donpivo/uv_lightbox/Schematic/PSU/PSU.kicad_pcb

## KiCad design Schematic/PSU/PSU.kicad_pcb (2020-11-04)

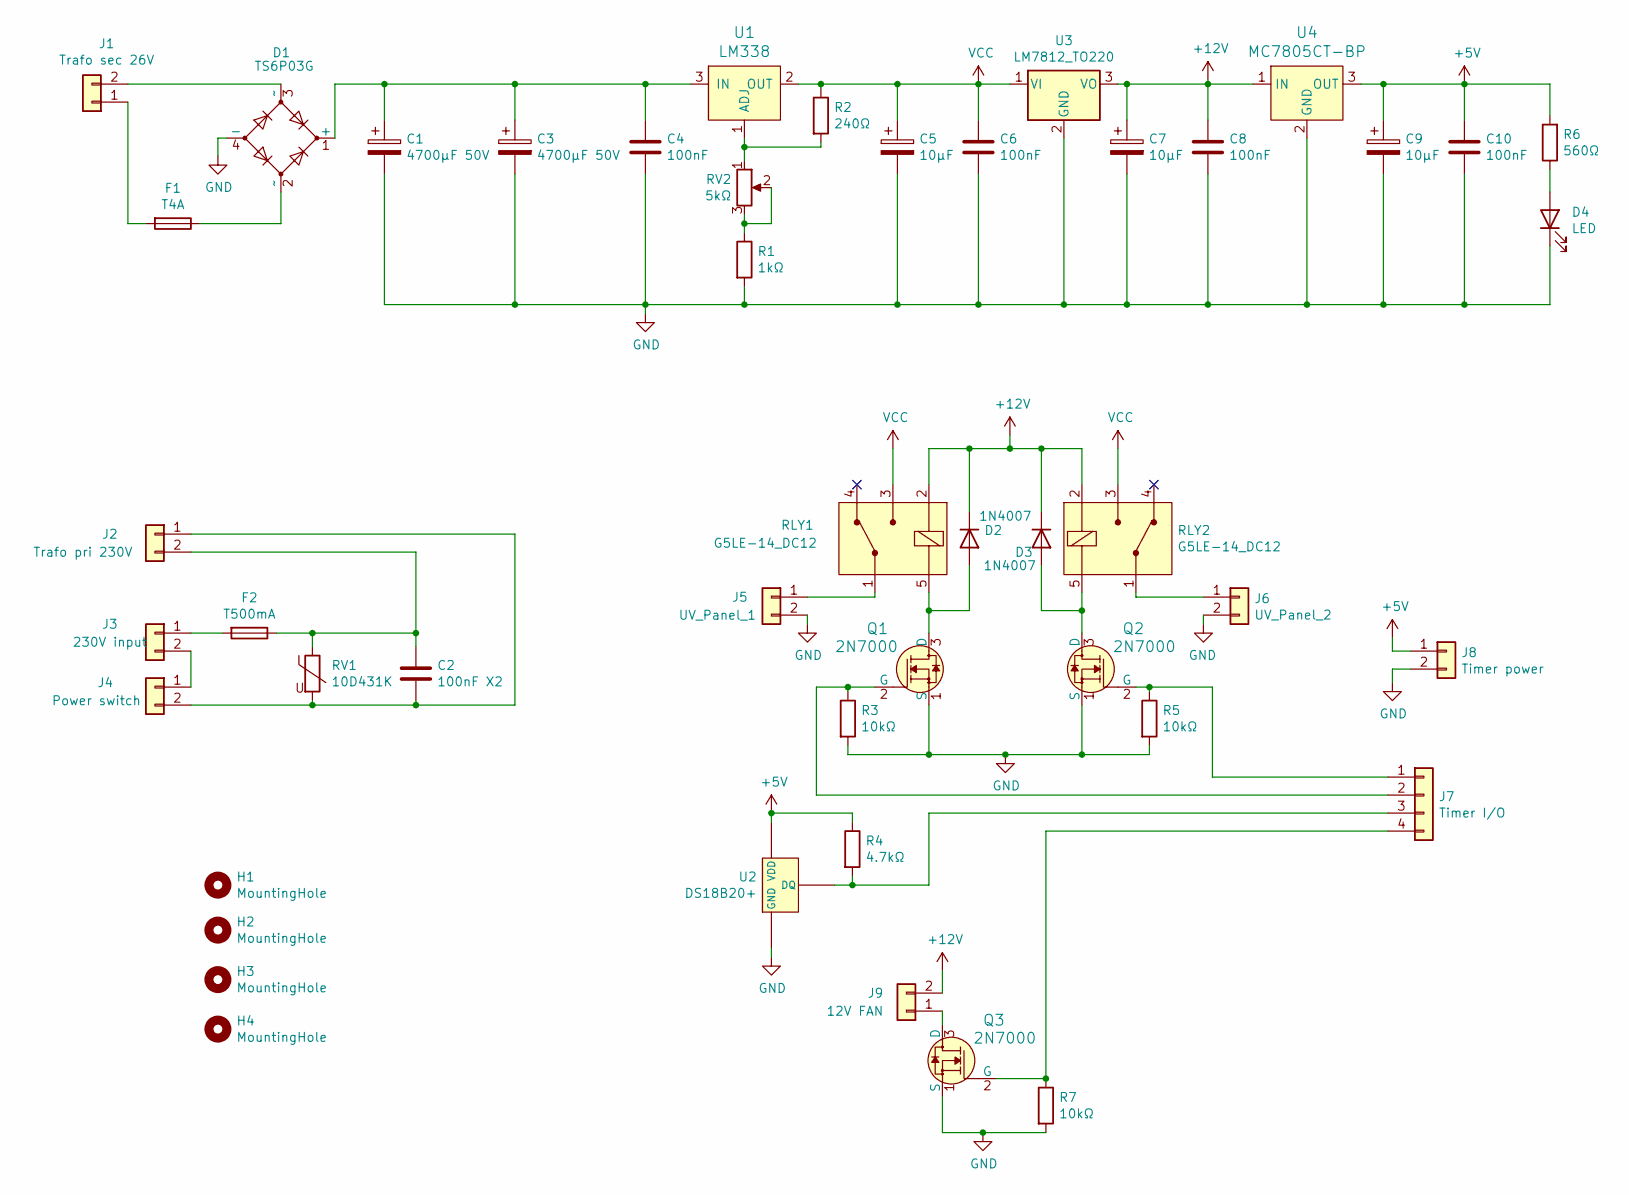
[picture p1: schematic PSU.sch]

Parts:
C1, C3: 4700µF 50V; CP_Radial_D22.0mm_P10.00mm_SnapIn
C2: 100nF X2; C_Rect_L18.0mm_W6.0mm_P15.00mm_FKS3_FKP3
C4, C6, C8, C10: 100nF; C_Rect_L7.2mm_W2.5mm_P5.00mm_FKS2_FKP2_MKS2_MKP2
C5, C7, C9: 10µF; CP_Radial_D5.0mm_P2.00mm
D1: TS6P03G; Generic_rectifier
D2, D3: 1N4007; D_DO-41_SOD81_P10.16mm_Horizontal
D4: LED; LED_D3.0mm
F1: T4A; Fuseholder_Cylinder-5x20mm_Closed
F2: T500mA; Fuseholder_Cylinder-5x20mm_Closed
H1, H2, H3, H4: MountingHole; MountingHole_3.2mm_M3
J1: Trafo sec 26V; TerminalBlock_LCSC_P5.08mm
J2: Trafo pri 230V; TerminalBlock_LCSC_P5.08mm
J3: 230V input; TerminalBlock_LCSC_P5.08mm
J4: Power switch; TerminalBlock_LCSC_P5.08mm
J5: UV_Panel_1; TerminalBlock_LCSC_P5.08mm
J6: UV_Panel_2; TerminalBlock_LCSC_P5.08mm
J7: Timer I/O; KF2510-4P
J8: Timer power; KF2510-2P
J9: 12V FAN; KF2510-2P
Q1, Q2, Q3: 2N7000; TO-92-3; MPN 2N7000; Digi-Key_PN 2N7000FS-ND
R1: 1kΩ; R_Axial_DIN0207_L6.3mm_D2.5mm_P7.62mm_Horizontal
R2: 240Ω; R_Axial_DIN0207_L6.3mm_D2.5mm_P7.62mm_Horizontal
R3, R5, R7: 10kΩ; R_Axial_DIN0207_L6.3mm_D2.5mm_P7.62mm_Horizontal
R4: 4.7kΩ; R_Axial_DIN0207_L6.3mm_D2.5mm_P7.62mm_Horizontal
R6: 560Ω; R_Axial_DIN0207_L6.3mm_D2.5mm_P7.62mm_Horizontal
RLY1, RLY2: G5LE-14_DC12; Relay_THT_G5LE-14; MPN G5LE-14 DC12; Digi-Key_PN Z1012-ND
RV1: 10D431K; RV_Disc_D12mm_W4.5mm_P7.5mm
RV2: 5kΩ; Potentiometer_Bourns_3296W_Vertical
U1: LM338; TO-220-3; MPN LM317T; Digi-Key_PN 497-1575-5-ND
U2: DS18B20+; TO127P482X368X883-3
U3: LM7812_TO220; TO-220-3
U4: MC7805CT-BP; TO-220-3; MPN MC7805CT-BP; Digi-Key_PN MC7805CT-BPMS-ND

Connections:
+5V: C9.1, C10.1, J8.1, R4.1, R6.2, U2.3 (VDD), U4.3 (OUT)
+12V: C7.1, C8.1, D2.1 (K), D3.1 (K), J9.2, RLY1.2 (COIL), RLY2.2 (COIL), U3.3 (VO), U4.1 (IN)
GND: C1.2, C3.2, C4.2, C5.2, C6.2, C7.2, C8.2, C9.2, C10.2, D1.4 (-), D4.1 (K), J5.2, J6.2, J8.2, Q1.1 (S), Q2.1 (S), Q3.1 (S), R1.2, R3.2, R5.2, R7.2, U2.1 (GND), U3.2 (GND), U4.2 (GND)
unnamed: C1.1, C3.1, C4.1, D1.1 (+), U1.3 (IN)
unnamed: C2.1, F2.1, J2.2, RV1.1
unnamed: C2.2, J2.1, J4.2, RV1.2
unnamed: D1.2 (~~), F1.1
unnamed: D1.3 (~~), J1.2
unnamed: D2.2 (A), Q1.3 (D), RLY1.5 (COIL)
unnamed: D3.2 (A), Q2.3 (D), RLY2.5 (COIL)
unnamed: D4.2 (A), R6.1
unnamed: F1.2, J1.1
unnamed: F2.2, J3.1
unnamed: J3.2, J4.1
unnamed: J5.1, RLY1.1 (COM)
unnamed: J6.1, RLY2.1 (COM)
unnamed: J7.1, Q2.2 (G), R5.1
unnamed: J7.2, Q1.2 (G), R3.1
unnamed: J7.3, R4.2, U2.2 (DQ)
unnamed: J7.4, Q3.2 (G), R7.1
unnamed: J9.1, Q3.3 (D)
unnamed: R1.1, RV2.2, RV2.3
unnamed: R2.2, RV2.1, U1.1 (ADJ)
VCC: C5.1, C6.1, R2.1, RLY1.3 (NO), RLY2.3 (NO), U1.2 (OUT), U3.1 (VI)

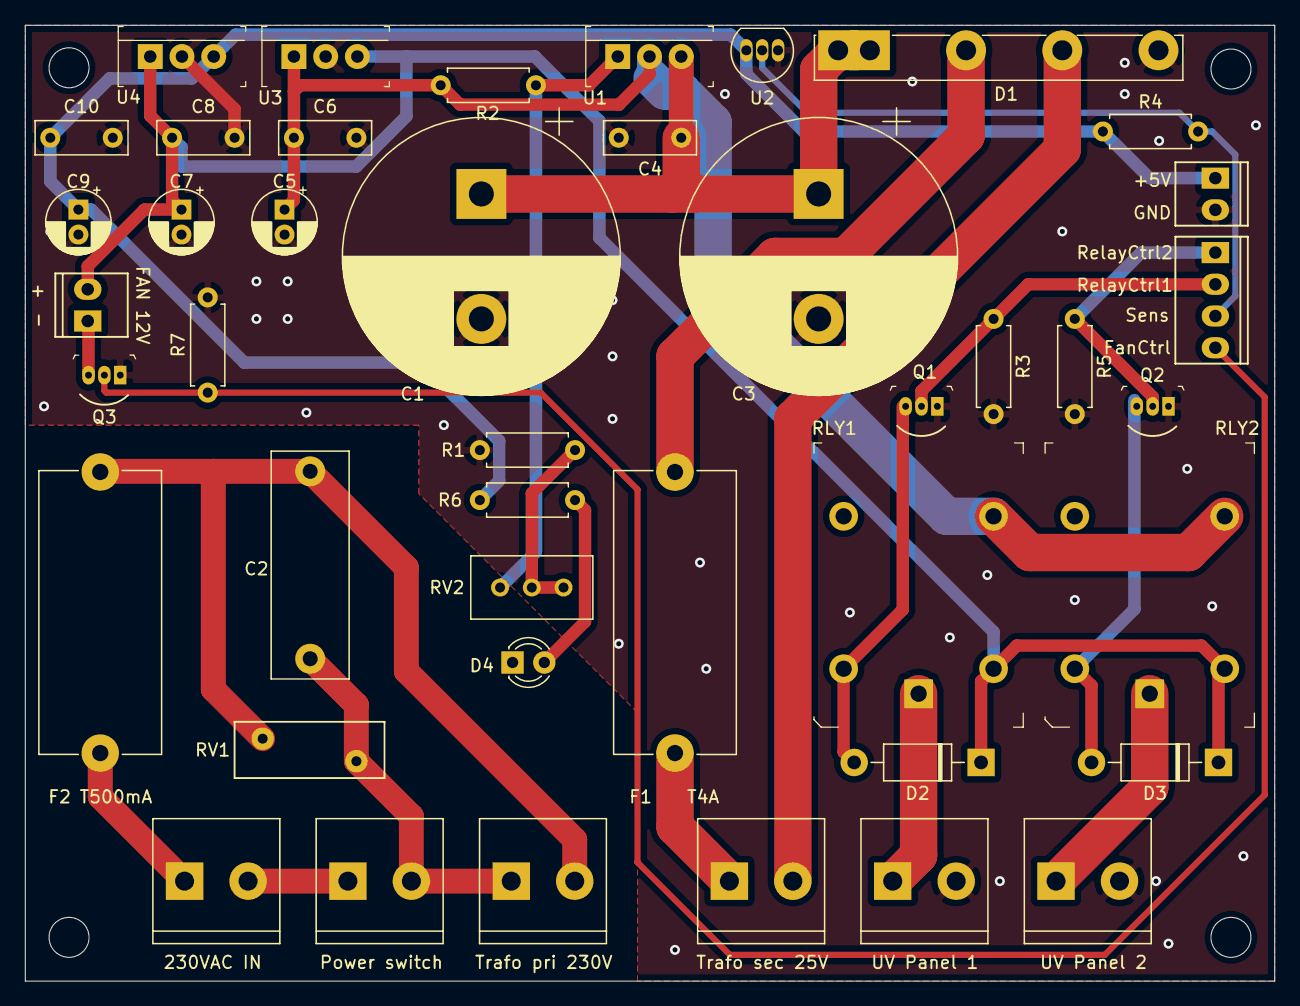
[picture p2: board PSU.kicad_pcb from above]

Board: 2 copper layers, 100.0 x 76.5 mm, 47 parts (0 on the bottom side), 24 nets.
