donpivo/uv_lightbox/Schematic/Timer/Timer.kicad_pcb

## KiCad design Schematic/Timer/Timer.kicad_pcb (2020-11-03)

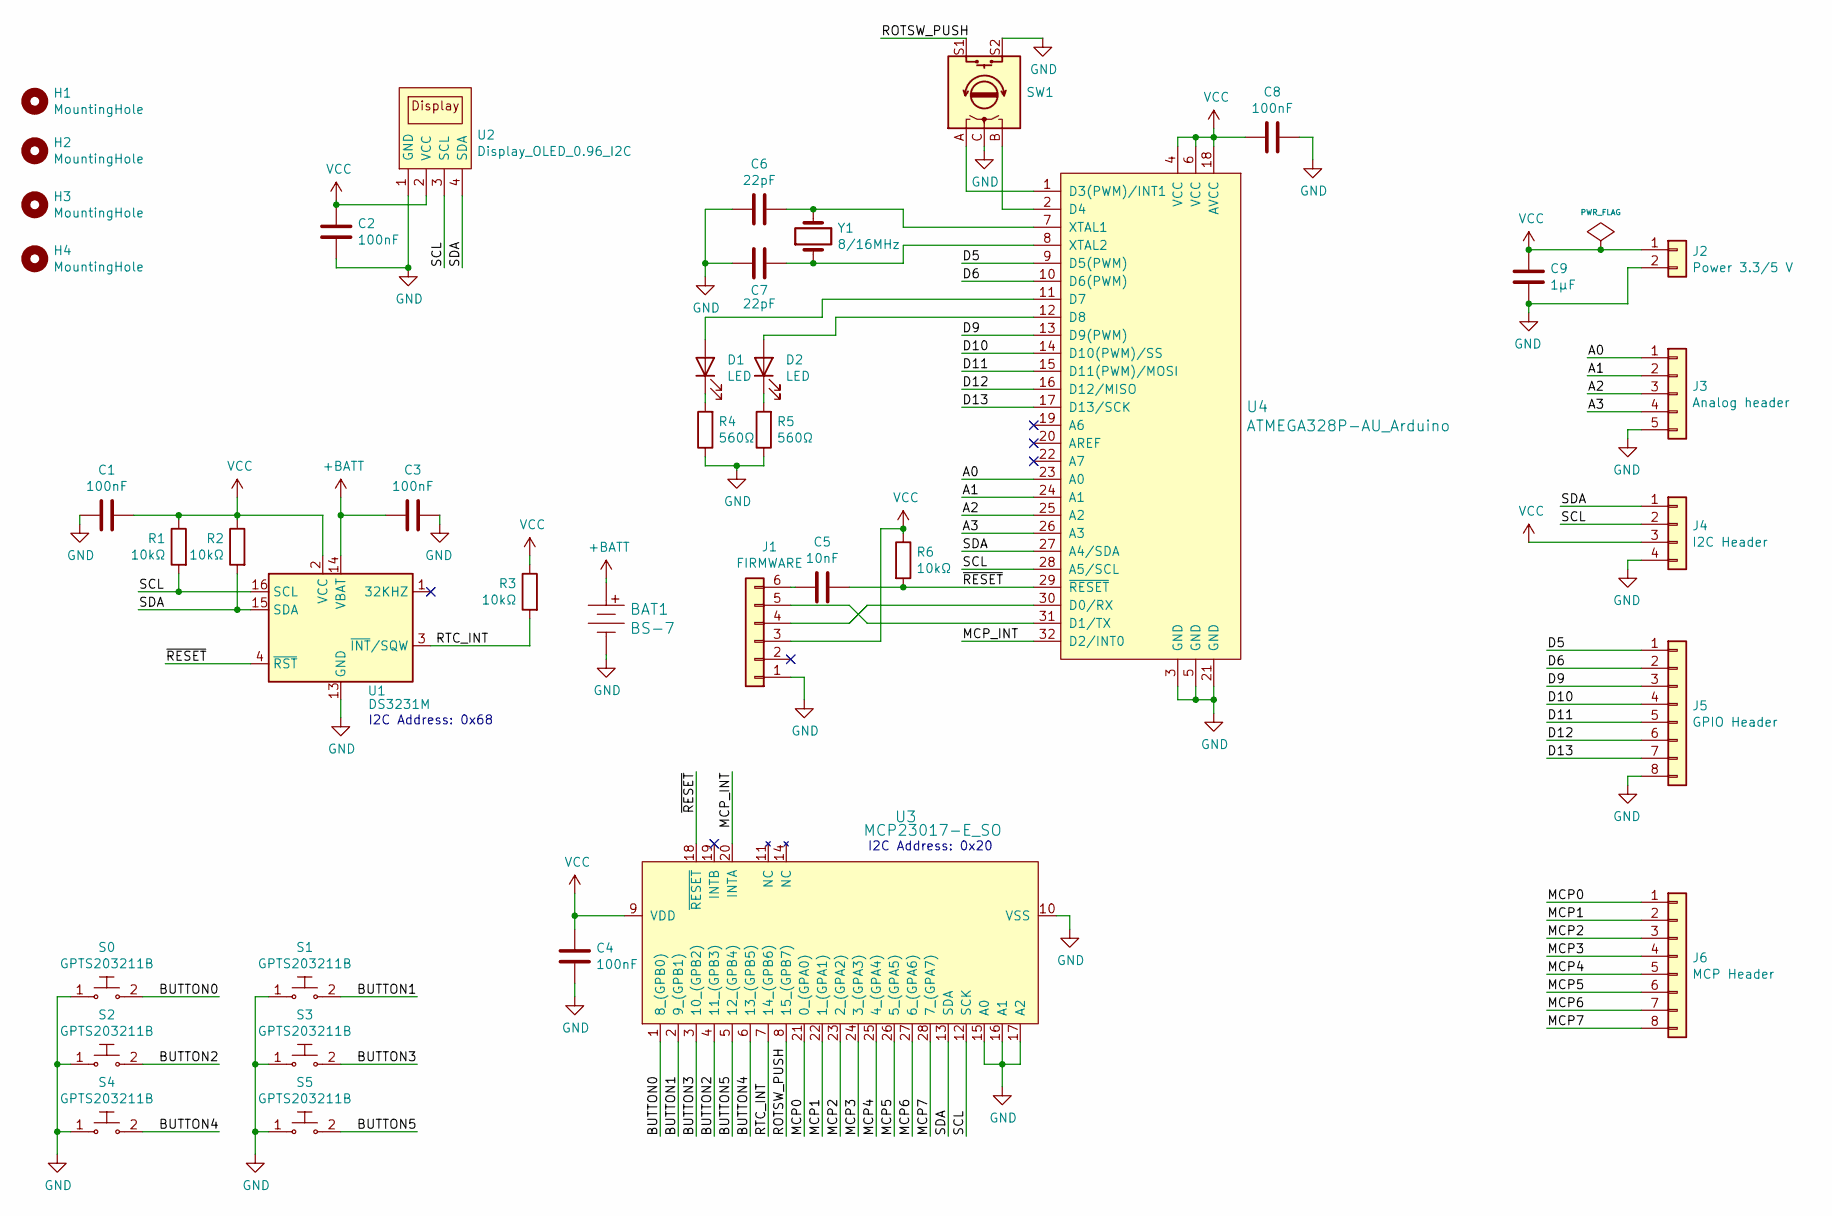
[picture p3: schematic Timer.sch, Generic Timer]

Parts:
BAT1: BS-7; Battery_Holder_Coin_2032_BS-7; MPN BS-7; Digi-Key_PN BS-7-ND
C1, C2, C3, C4, C8: 100nF; C_0805_2012Metric_Pad1.15x1.40mm_HandSolder
C5: 10nF; C_0805_2012Metric_Pad1.15x1.40mm_HandSolder
C6, C7: 22pF; C_0805_2012Metric_Pad1.15x1.40mm_HandSolder
C9: 1µF; C_0805_2012Metric_Pad1.15x1.40mm_HandSolder
D1, D2: LED; LED_0805_2012Metric_Pad1.15x1.40mm_HandSolder
H1, H2, H3, H4: MountingHole; MountingHole_3.2mm_M3
J1: FIRMWARE; PinHeader_1x06_P2.54mm_Vertical
J2: Power 3.3/5 V; KF2510-2P
J3: Analog header; KF2510-5P
J4: I2C Header; KF2510-4P
J5: GPIO Header; KF2510-8P
J6: MCP Header; KF2510-8P
R1, R2, R3, R6: 10kΩ; R_0805_2012Metric_Pad1.15x1.40mm_HandSolder
R4, R5: 560Ω; R_0805_2012Metric_Pad1.15x1.40mm_HandSolder
S0, S1, S2, S3, S4, S5: GPTS203211B; SW_PUSH_6mm_H7.3mm; MPN GPTS203211B; Digi-Key_PN CW181-ND
SW1: Rotary_Encoder_Switch; RotaryEncoder_Alps_EC11E-Switch_Vertical_H20mm
U1: DS3231M; SOIC-16W_7.5x10.3mm_P1.27mm
U2: Display_OLED_0.96_I2C; Display_OLED_0.96in_I2C
U3: MCP23017-E_SO; SOIC-28_W7.5mm
U4: ATMEGA328P-AU_Arduino; TQFP-32_7x7mm
Y1: 8/16MHz; Crystal_SMD_HC49-SD

Connections:
+BATT: BAT1.Pos, C3.1, U1.14 (VBAT)
/A0: J3.1, U4.23 (A0)
/A1: J3.2, U4.24 (A1)
/A2: J3.3, U4.25 (A2)
/A3: J3.4, U4.26 (A3)
/BUTTON0: S0.2, U3.1 (8_(GPB0))
/BUTTON1: S1.2, U3.2 (9_(GPB1))
/BUTTON2: S2.2, U3.4 (11_(GPB3))
/BUTTON3: S3.2, U3.3 (10_(GPB2))
/BUTTON4: S4.2, U3.6 (13_(GPB5))
/BUTTON5: S5.2, U3.5 (12_(GPB4))
/D5: J5.1, U4.9 (D5(PWM))
/D6: J5.2, U4.10 (D6(PWM))
/D9: J5.3, U4.13 (D9(PWM))
/D10: J5.4, U4.14 (D10(PWM)/SS)
/D11: J5.5, U4.15 (D11(PWM)/MOSI)
/D12: J5.6, U4.16 (D12/MISO)
/D13: J5.7, U4.17 (D13/SCK)
/MCP0: J6.1, U3.21 (0_(GPA0))
/MCP1: J6.2, U3.22 (1_(GPA1))
/MCP2: J6.3, U3.23 (2_(GPA2))
/MCP3: J6.4, U3.24 (3_(GPA3))
/MCP4: J6.5, U3.25 (4_(GPA4))
/MCP5: J6.6, U3.26 (5_(GPA5))
/MCP6: J6.7, U3.27 (6_(GPA6))
/MCP7: J6.8, U3.28 (7_(GPA7))
/MCP_INT: U3.20 (INTA), U4.32 (D2/INT0)
/ROTSW_PUSH: SW1.S1, U3.8 (15_(GPB7))
/RTC_INT: R3.2, U1.3 (~INT~/SQW), U3.7 (14_(GPB6))
/SCL: J4.2, R1.2, U1.16 (SCL), U2.3 (SCL), U3.12 (SCK), U4.28 (A5/SCL)
/SDA: J4.1, R2.2, U1.15 (SDA), U2.4 (SDA), U3.13 (SDA), U4.27 (A4/SDA)
/~RESET: C5.2, R6.2, U1.4 (~RST), U3.18 (~RESET), U4.29 (~RESET~)
GND: BAT1.Neg, C1.2, C2.1, C3.2, C4.1, C6.1, C7.1, C8.1, C9.1, J1.1, J2.2, J3.5, J4.4, J5.8, R4.1, R5.1, S0.1, S1.1, S2.1, S3.1, S4.1, S5.1, SW1.C, SW1.S2, U1.5 (GND), U1.6 (GND), U1.7 (GND), U1.8 (GND), U1.9 (GND), U1.10 (GND), U1.11 (GND), U1.12 (GND), U1.13 (GND), U2.1 (GND), U3.10 (VSS), U3.15 (A0), U3.16 (A1), U3.17 (A2), U4.3 (GND), U4.5 (GND), U4.21 (GND)
unnamed: C5.1, J1.6
unnamed: C6.2, U4.7 (XTAL1), Y1.2
unnamed: C7.2, U4.8 (XTAL2), Y1.1
unnamed: D1.1 (K), R4.2
unnamed: D1.2 (A), U4.11 (D7)
unnamed: D2.1 (K), R5.2
unnamed: D2.2 (A), U4.12 (D8)
unnamed: J1.4, U4.30 (D0/RX)
unnamed: J1.5, U4.31 (D1/TX)
unnamed: SW1.A, U4.1 (D3(PWM)/INT1)
unnamed: SW1.B, U4.2 (D4)
VCC: C1.1, C2.2, C4.2, C8.2, C9.2, J1.3, J2.1, J4.3, R1.1, R2.1, R3.1, R6.1, U1.2 (VCC), U2.2 (VCC), U3.9 (VDD), U4.4 (VCC), U4.6 (VCC), U4.18 (AVCC)

Notes on the sheet:
I2C Address: 0x68
I2C Address: 0x20

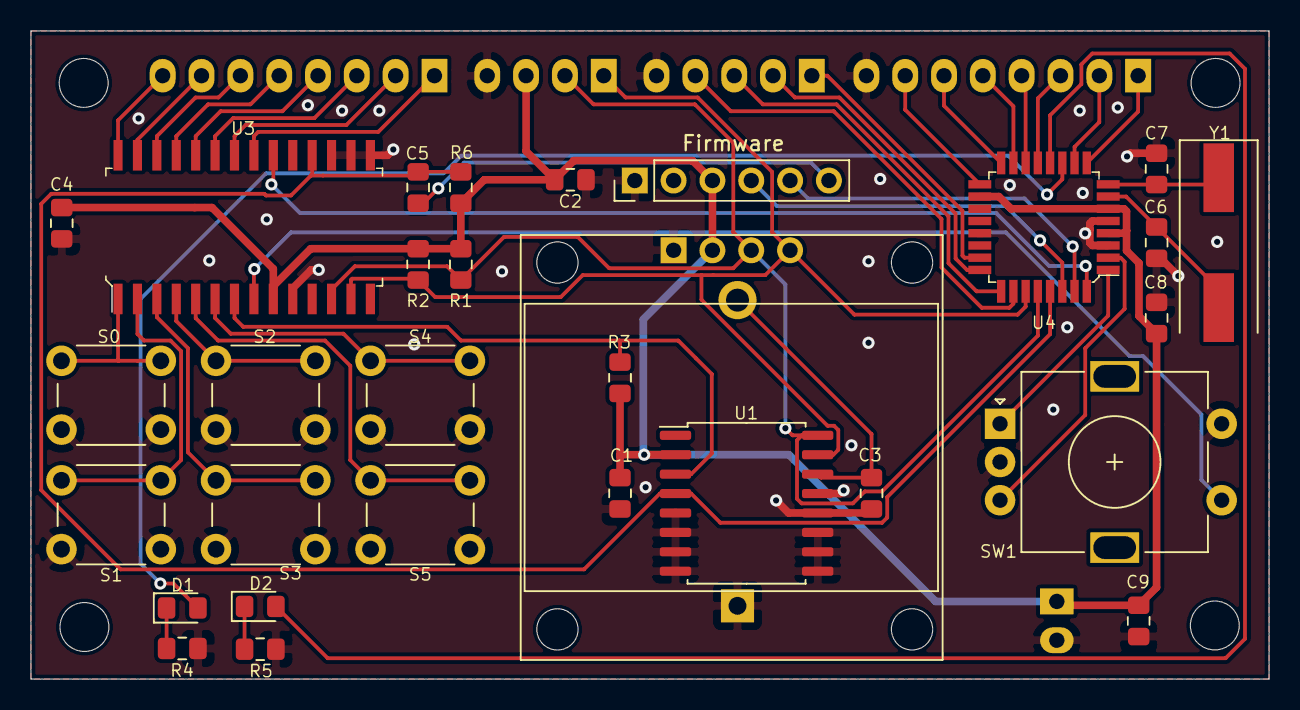
[picture p4: board Timer.kicad_pcb from above]

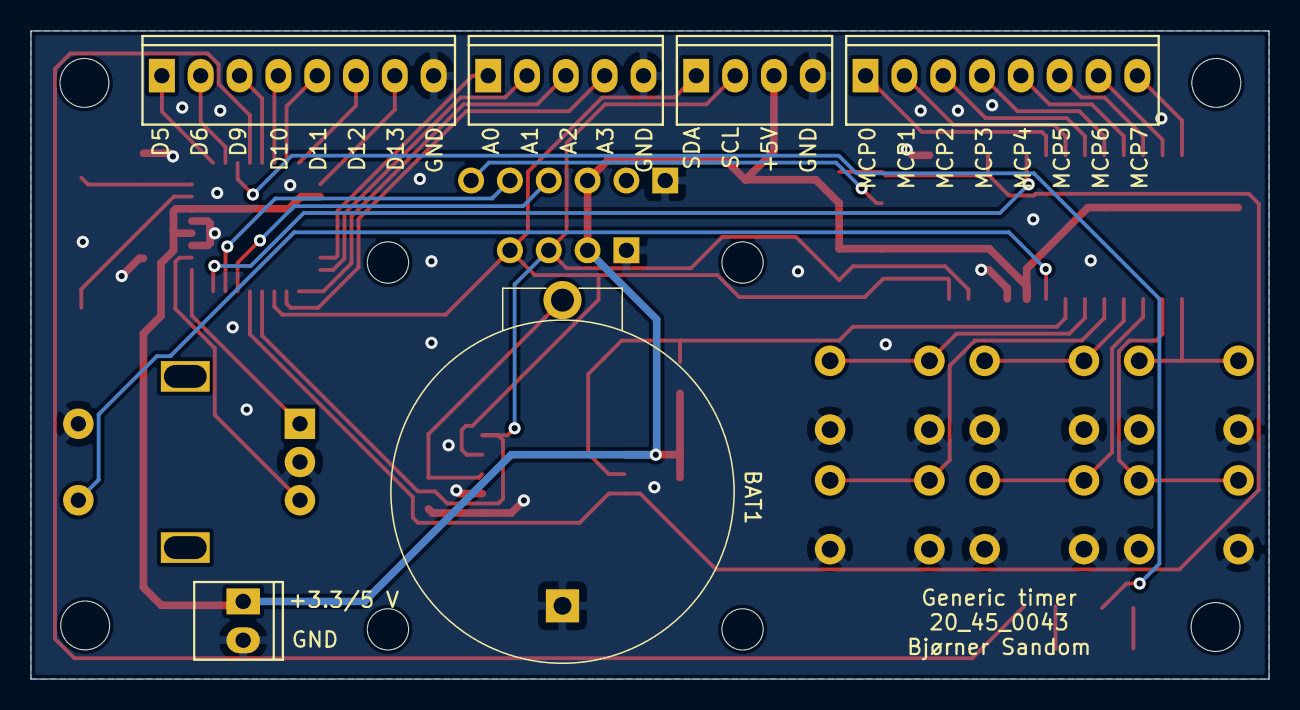
[picture p5: board Timer.kicad_pcb from below]

Board: 2 copper layers, 81.0 x 42.4 mm, 40 parts (6 on the bottom side), 45 nets.
