donpivo/uv_lightbox/Schematic/LED_Panel/LED_Panel.kicad_pcb

## KiCad design Schematic/LED_Panel/LED_Panel.kicad_pcb (2020-11-03)

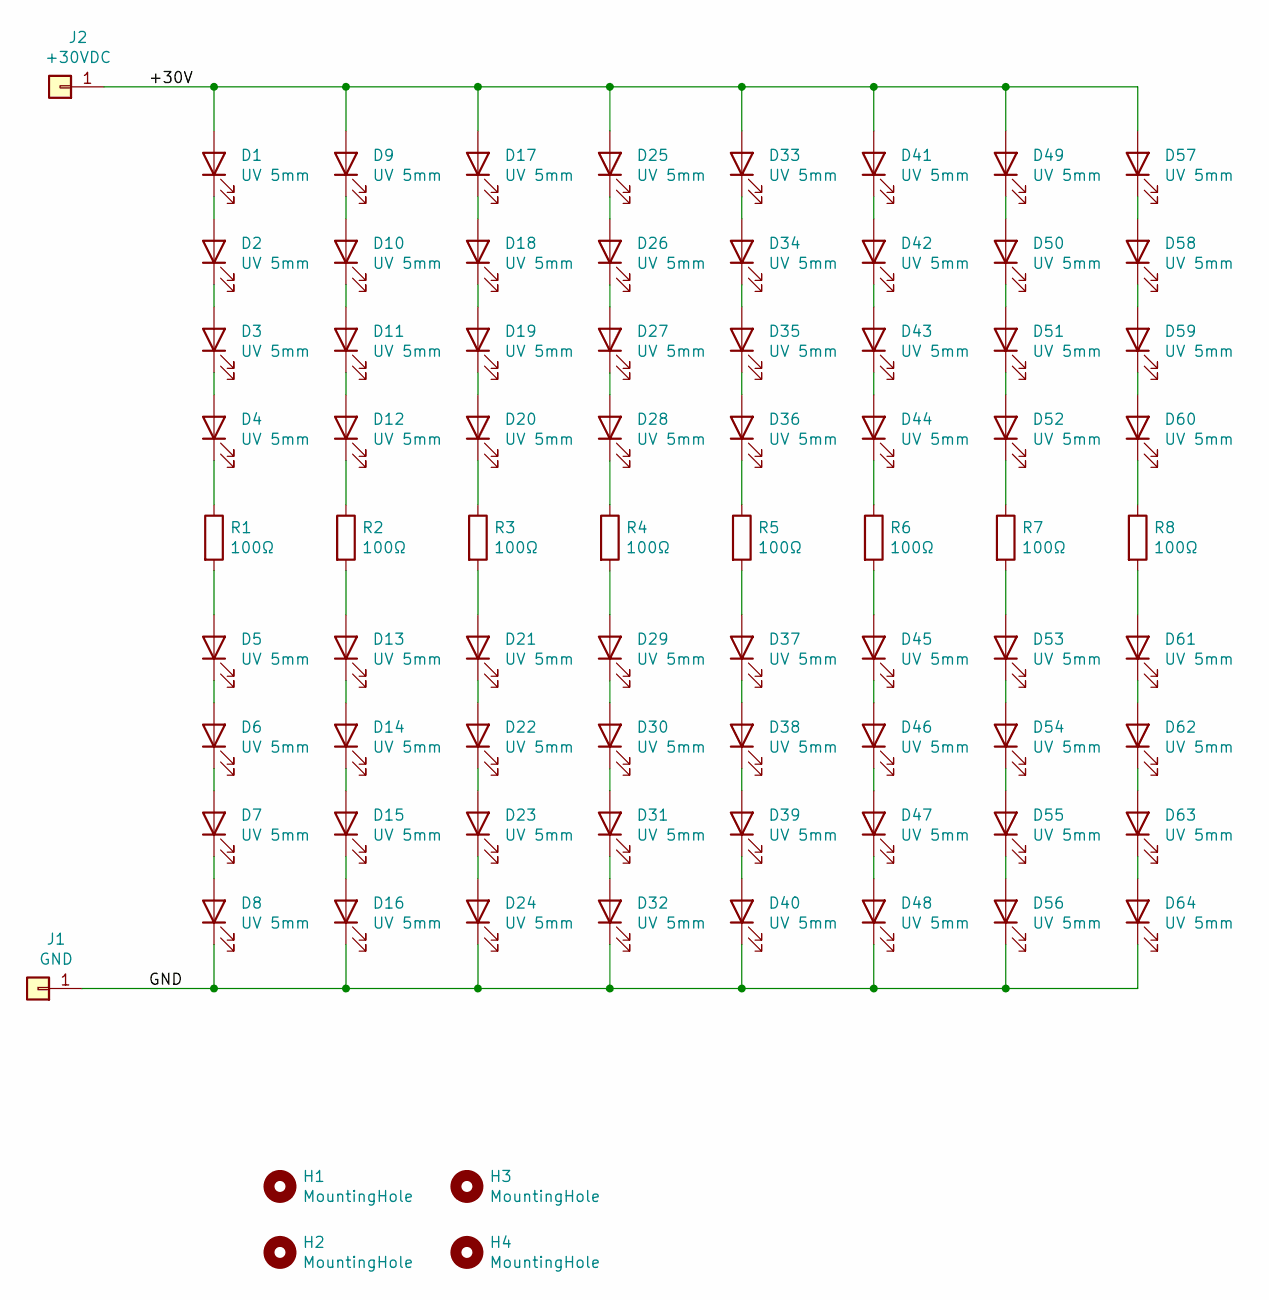
[picture p6: schematic LED_Panel.sch]

Parts:
D1, D2, D3, D4, D5, D6, D7, D8, D9, D10, D11, D12, D13, D14, D15, D16, D17, D18, D19, D20, D21, D22, D23, D24, D25, D26, D27, D28, D29, D30, D31, D32, D33, D34, D35, D36, D37, D38, D39, D40, D41, D42, D43, D44, D45, D46, D47, D48, D49, D50, D51, D52, D53, D54, D55, D56, D57, D58, D59, D60, D61, D62, D63, D64: UV 5mm; LED_D5.0mm_Clear
H1, H2, H3, H4: MountingHole; MountingHole_3.2mm_M3
J1: GND; TestPoint_Loop_D3.80mm_Drill2.0mm
J2: +30VDC; TestPoint_Loop_D3.80mm_Drill2.0mm
R1, R2, R3, R4, R5, R6, R7, R8: 100Ω; R_Axial_DIN0207_L6.3mm_D2.5mm_P7.62mm_Horizontal

Connections:
/+30V: D1.2 (A), D9.2 (A), D17.2 (A), D25.2 (A), D33.2 (A), D41.2 (A), D49.2 (A), D57.2 (A), J2.1
/GND: D8.1 (K), D16.1 (K), D24.1 (K), D32.1 (K), D40.1 (K), D48.1 (K), D56.1 (K), D64.1 (K), J1.1
unnamed: D1.1 (K), D2.2 (A)
unnamed: D2.1 (K), D3.2 (A)
unnamed: D3.1 (K), D4.2 (A)
unnamed: D4.1 (K), R1.1
unnamed: D5.1 (K), D6.2 (A)
unnamed: D5.2 (A), R1.2
unnamed: D6.1 (K), D7.2 (A)
unnamed: D7.1 (K), D8.2 (A)
unnamed: D10.1 (K), D11.2 (A)
unnamed: D9.1 (K), D10.2 (A)
unnamed: D11.1 (K), D12.2 (A)
unnamed: D12.1 (K), R2.1
unnamed: D13.1 (K), D14.2 (A)
unnamed: D13.2 (A), R2.2
unnamed: D14.1 (K), D15.2 (A)
unnamed: D15.1 (K), D16.2 (A)
unnamed: D17.1 (K), D18.2 (A)
unnamed: D18.1 (K), D19.2 (A)
unnamed: D19.1 (K), D20.2 (A)
unnamed: D20.1 (K), R3.1
unnamed: D21.1 (K), D22.2 (A)
unnamed: D21.2 (A), R3.2
unnamed: D22.1 (K), D23.2 (A)
unnamed: D23.1 (K), D24.2 (A)
unnamed: D25.1 (K), D26.2 (A)
unnamed: D26.1 (K), D27.2 (A)
unnamed: D27.1 (K), D28.2 (A)
unnamed: D28.1 (K), R4.1
unnamed: D29.1 (K), D30.2 (A)
unnamed: D29.2 (A), R4.2
unnamed: D30.1 (K), D31.2 (A)
unnamed: D31.1 (K), D32.2 (A)
unnamed: D33.1 (K), D34.2 (A)
unnamed: D34.1 (K), D35.2 (A)
unnamed: D35.1 (K), D36.2 (A)
unnamed: D36.1 (K), R5.1
unnamed: D37.1 (K), D38.2 (A)
unnamed: D37.2 (A), R5.2
unnamed: D38.1 (K), D39.2 (A)
unnamed: D39.1 (K), D40.2 (A)
unnamed: D41.1 (K), D42.2 (A)
unnamed: D42.1 (K), D43.2 (A)
unnamed: D43.1 (K), D44.2 (A)
unnamed: D44.1 (K), R6.1
unnamed: D45.1 (K), D46.2 (A)
unnamed: D45.2 (A), R6.2
unnamed: D46.1 (K), D47.2 (A)
unnamed: D47.1 (K), D48.2 (A)
unnamed: D49.1 (K), D50.2 (A)
unnamed: D50.1 (K), D51.2 (A)
unnamed: D51.1 (K), D52.2 (A)
unnamed: D52.1 (K), R7.1
unnamed: D53.1 (K), D54.2 (A)
unnamed: D53.2 (A), R7.2
unnamed: D54.1 (K), D55.2 (A)
unnamed: D55.1 (K), D56.2 (A)
unnamed: D57.1 (K), D58.2 (A)
unnamed: D58.1 (K), D59.2 (A)
unnamed: D59.1 (K), D60.2 (A)
unnamed: D60.1 (K), R8.1
unnamed: D61.1 (K), D62.2 (A)
unnamed: D61.2 (A), R8.2
unnamed: D62.1 (K), D63.2 (A)
unnamed: D63.1 (K), D64.2 (A)

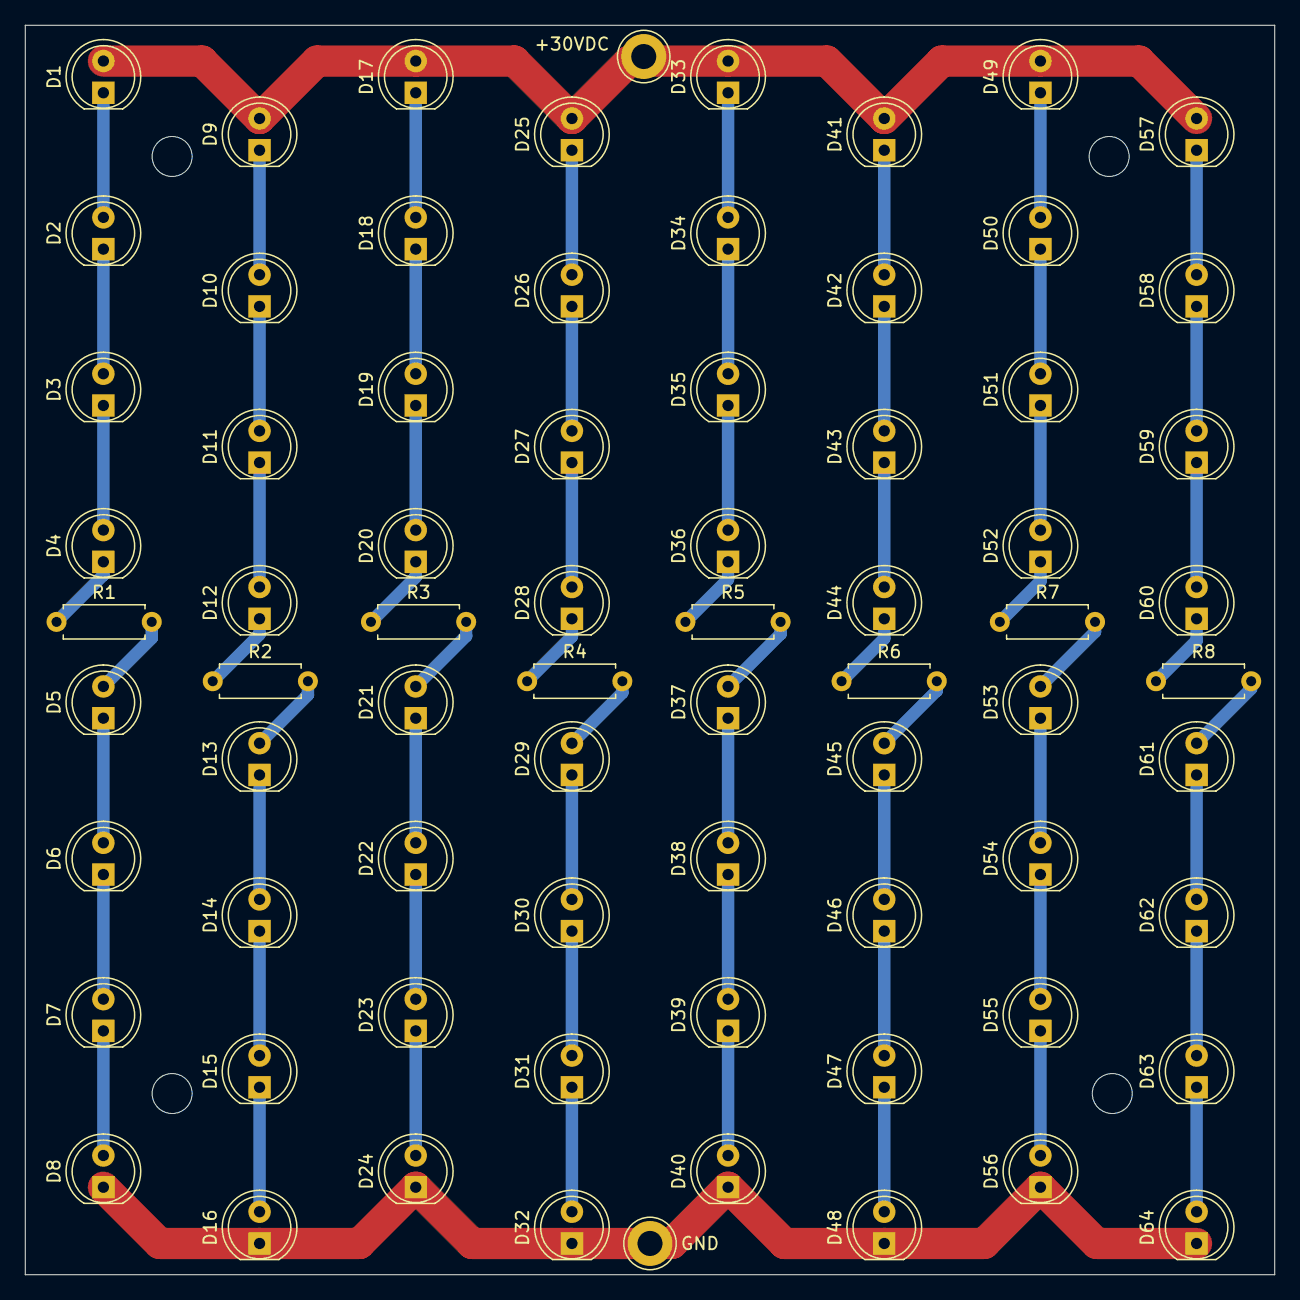
[picture p7: board LED_Panel.kicad_pcb from above]

Board: 2 copper layers, 100.0 x 100.0 mm, 78 parts (0 on the bottom side), 66 nets.
