donpivo/uv_lightbox/(commit log)

2020-11-03 Early version with DS3231M RTC
    [LED_Panel-B_Cu.gbr, LED_Panel-B_Mask.gbr, LED_Panel-B_SilkS.gbr, LED_Panel-Edge_Cuts.gbr, LED_Panel-F_Cu.gbr, LED_Panel-F_Mask.gbr, LED_Panel-F_SilkS.gbr, LED_Panel-NPTH.drl]
2020-11-03 New timer with the more precise DS3231 + more digital I/O ports exposed.
    [Timer-B_Cu.gbr, Timer-B_Mask.gbr, Timer-B_SilkS.gbr, Timer-Edge_Cuts.gbr, Timer-F_Cu.gbr, Timer-F_Mask.gbr, Timer-F_SilkS.gbr, Timer-NPTH.drl]
2020-11-03 PSU board: Added temperature sensor and fan driver. 12V relays.
    [PSU-B_Cu.gbr, PSU-B_Mask.gbr, PSU-B_SilkS.gbr, PSU-Edge_Cuts.gbr, PSU-F_Cu.gbr, PSU-F_Mask.gbr, PSU-F_SilkS.gbr, PSU-NPTH.drl]
2020-11-04 PSU: corrected silkscreen for timer inputs
    [PSU-B_Cu.gbr, PSU-B_Mask.gbr, PSU-B_SilkS.gbr, PSU-Edge_Cuts.gbr, PSU-F_Cu.gbr, PSU-F_Mask.gbr, PSU-F_SilkS.gbr, PSU-NPTH.drl]
2020-12-04 Code for hardware test
    [Timer.sch]
